MorseScout/hardware/morse_scout_custom_io_elecrow.kicad_pcb

## KiCad design morse_scout_custom_io_elecrow.kicad_pcb (2026-10-28)

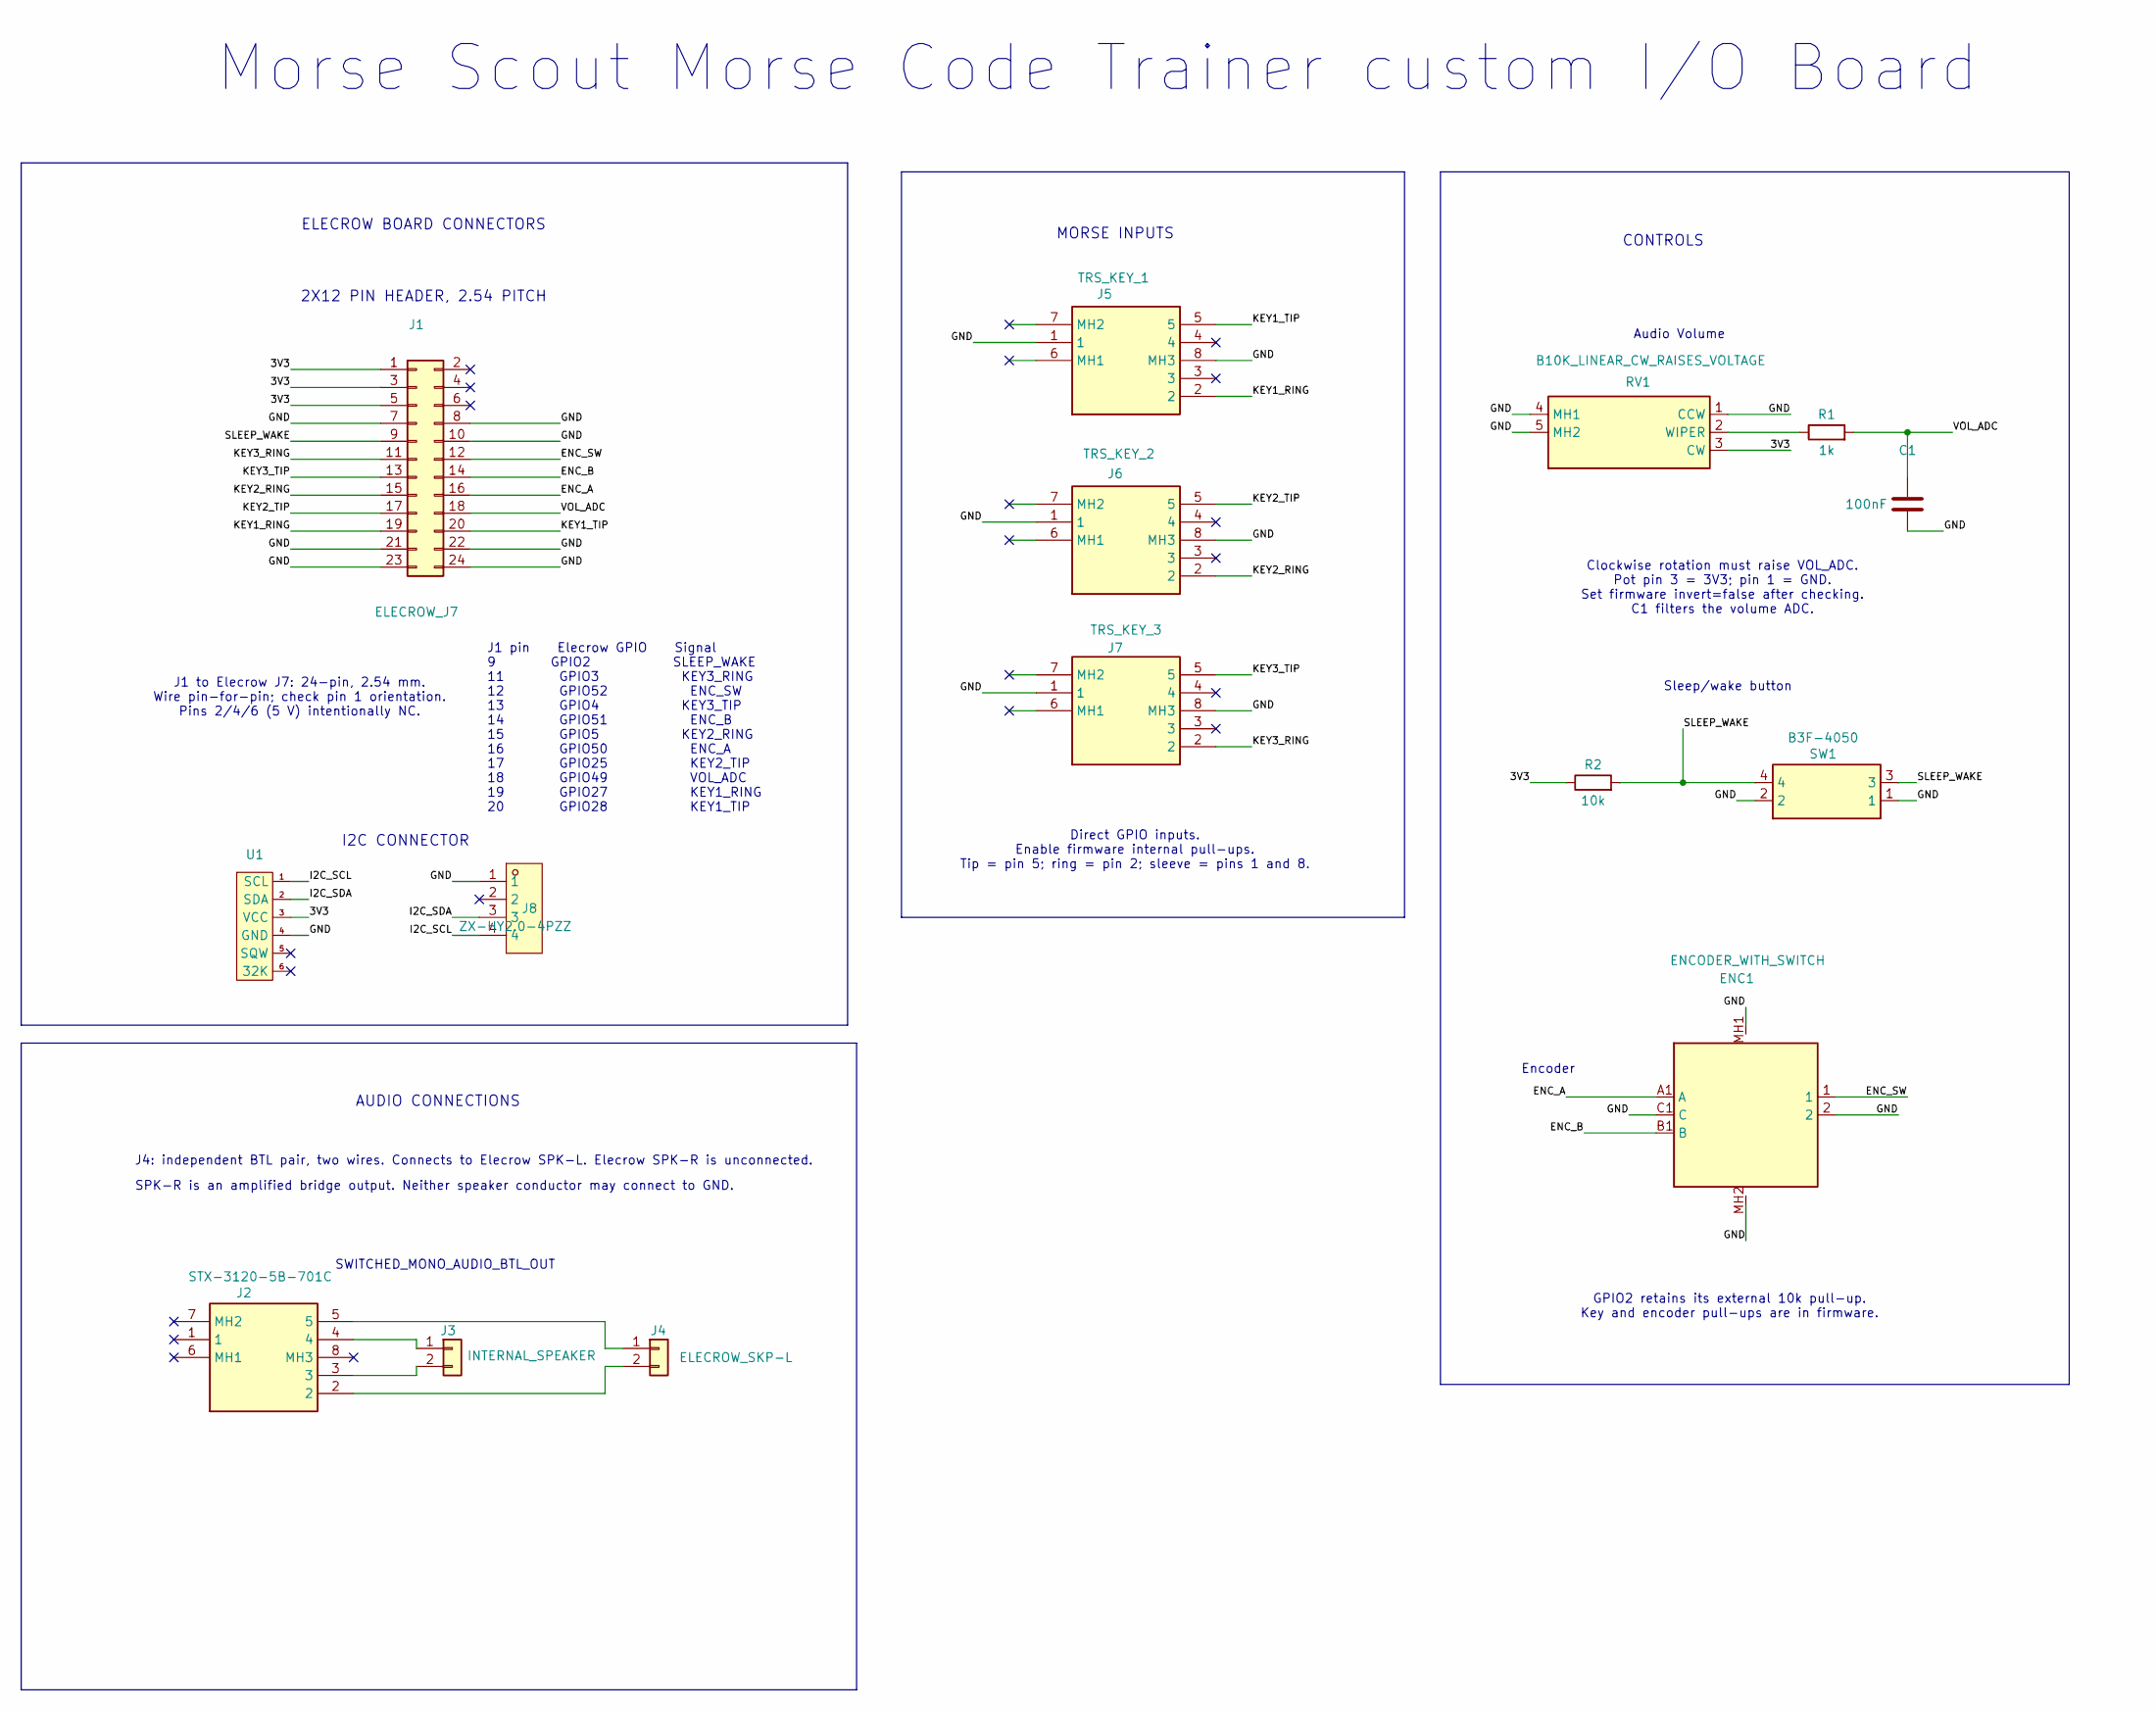
[picture p1: schematic morse_scout_custom_io_elecrow.kicad_sch, Morse Scout Custom I/O - Elecrow]

Parts:
C1: 100nF; C_Disc_D5.0mm_W2.5mm_P5.00mm
ENC1: ENCODER_WITH_SWITCH; PEC11R-4230F-S0024; Manufacturer_Part_Number PEC11R-4230F-S0024; Mouser Part Number 652-PEC11R-4230F-S24
J1: ELECROW_J7; IDC-Header_2x12_P2.54mm_Vertical
J2: STX-3120-5B-701C; Manufacturer_Part_Number STX-3120-5B-701C; Mouser Part Number 806-STX-31205B701C
J3: INTERNAL_SPEAKER; JST_PH_B2B-PH-K_1x02_P2.00mm_Vertical
J4: ELECROW_SKP-L; JST_PH_B2B-PH-K_1x02_P2.00mm_Vertical
J5: TRS_KEY_1; STX-3120-5B-701C; Manufacturer_Part_Number STX-3120-5B-701C; Mouser Part Number 806-STX-31205B701C
J6: TRS_KEY_2; STX-3120-5B-701C; Manufacturer_Part_Number STX-3120-5B-701C; Mouser Part Number 806-STX-31205B701C
J7: TRS_KEY_3; STX-3120-5B-701C; Manufacturer_Part_Number STX-3120-5B-701C; Mouser Part Number 806-STX-31205B701C
J8: ZX-HY2.0-4PZZ; CONN-TH_4P-P2.00_HX20020-4A_2; MPN ZX-HY2.0-4PZZ; LCSC Part C7429580
R1: 1k; R_Axial_DIN0204_L3.6mm_D1.6mm_P7.62mm_Horizontal
R2: 10k; R_Axial_DIN0204_L3.6mm_D1.6mm_P7.62mm_Horizontal
RV1: B10K_LINEAR_CW_RAISES_VOLTAGE; PTV09A-4030F-B103; Mouser Part Number 652-PTV09A4030FB103
SW1: B3F-4050
U1: DS3231_RTC_Module

Connections:
/3V3: J1.1, J1.3, J1.5, R2.1, RV1.3 (CW), U1.3 (VCC)
/ENC_A: ENC1.A1 (A), J1.16
/ENC_B: ENC1.B1 (B), J1.14
/ENC_SW: ENC1.1, J1.12
/GND: C1.2, ENC1.2, ENC1.C1 (C), ENC1.MH1, ENC1.MH2, J1.7, J1.8, J1.10, J1.21, J1.22, J1.23, J1.24, J5.1, J5.8 (MH3), J6.1, J6.8 (MH3), J7.1, J7.8 (MH3), J8.1, RV1.1 (CCW), RV1.4 (MH1), RV1.5 (MH2), SW1.1, SW1.2, U1.4 (GND)
/I2C_SCL: J8.4, U1.1 (SCL)
/I2C_SDA: J8.3, U1.2 (SDA)
/KEY1_RING: J1.19, J5.2
/KEY1_TIP: J1.20, J5.5
/KEY2_RING: J1.15, J6.2
/KEY2_TIP: J1.17, J6.5
/KEY3_RING: J1.11, J7.2
/KEY3_TIP: J1.13, J7.5
/SLEEP_WAKE: J1.9, R2.2, SW1.3, SW1.4
/VOL_ADC: C1.1, J1.18, R1.2
unnamed: J2.4, J3.1
unnamed: J2.3, J3.2
unnamed: J2.5, J4.1
unnamed: J2.2, J4.2
unnamed: R1.1, RV1.2 (WIPER)

Notes on the sheet:
MORSE INPUTS
Direct GPIO inputs. Enable firmware internal pull-ups. Tip = pin 5; ring = pin 2; sleeve = pins 1 and 8.
I2C CONNECTOR
Audio Volume
SPK-R is an amplified bridge output. Neither speaker conductor may connect to GND.
Sleep/wake button
ELECROW BOARD CONNECTORS
SWITCHED_MONO_AUDIO_BTL_OUT
CONTROLS
J4: independent BTL pair, two wires. Connects to Elecrow SPK-L. Elecrow SPK-R is unconnected.
Morse Scout Morse Code Trainer custom I/O Board
Encoder
GPIO2 retains its external 10k pull-up. Key and encoder pull-ups are in firmware.
AUDIO CONNECTIONS
J1 to Elecrow J7: 24-pin, 2.54 mm. Wire pin-for-pin; check pin 1 orientation. Pins 2/4/6 (5 V) intentionally NC.
2X12 PIN HEADER, 2.54 PITCH
Clockwise rotation must raise VOL_ADC. Pot pin 3 = 3V3; pin 1 = GND. Set firmware invert=false after checking. C1 filters the volume ADC.
J1 pin Elecrow GPIO Signal 9 GPIO2 SLEEP_WAKE 11 GPIO3 KEY3_RING 12 GPIO52 ENC_SW 13 GPIO4 KEY3_TIP 14 GPIO51 ENC_B 15 GPIO5 KEY2_RING 16 GPIO50 ENC_A 17 GPIO25 KEY2_TIP 18 GPIO49 VOL_ADC 19 GPIO27 KEY1_RING 20 GPIO28 KEY1_TIP

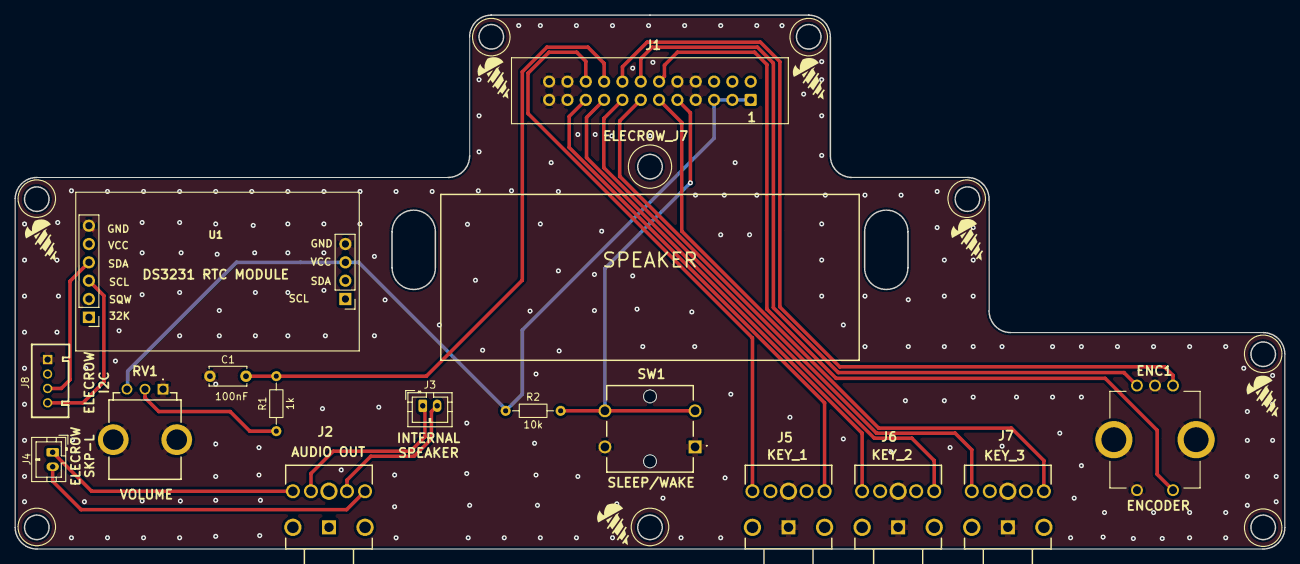
[picture p2: board morse_scout_custom_io_elecrow.kicad_pcb from above]

Board: 2 copper layers, 176.0 x 74.0 mm, 15 parts (1 on the bottom side), 20 nets.
